PatrickBaus/LiPo_heater/images/main.png

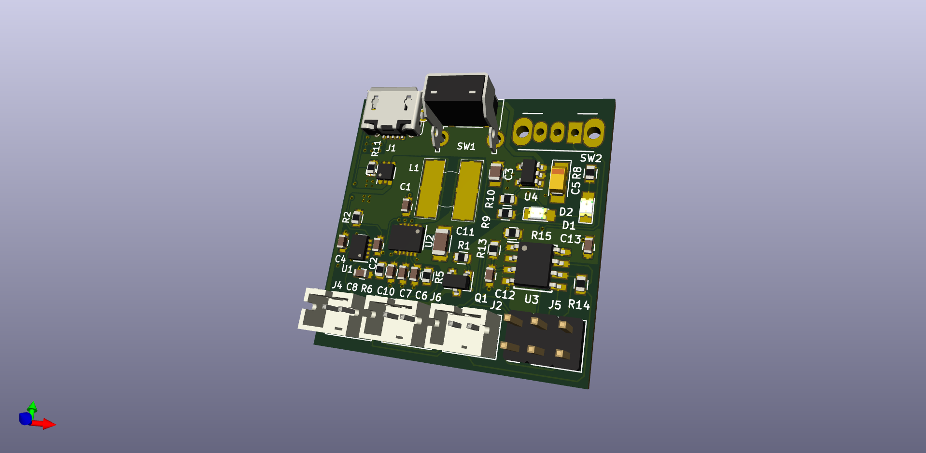
images/main.png
