PatrickBaus/LiPo_heater/components/Seuthe_nr-5.jpg

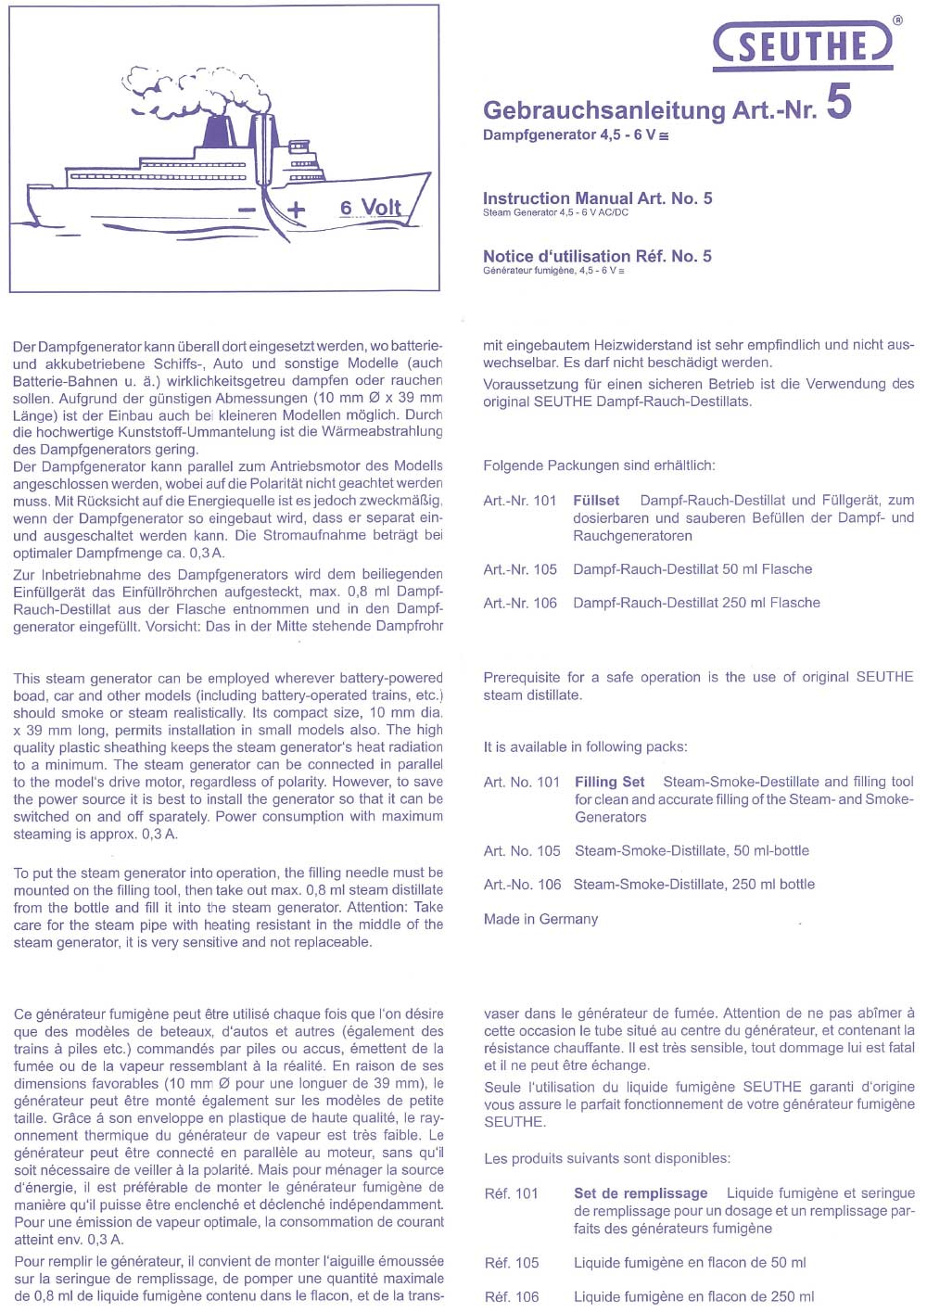
components/Seuthe_nr-5.jpg
