PatrickBaus/LiPo_heater/main.kicad_pcb

## KiCad design main.kicad_pcb (2018-06-10)

Schematic: main.sch

Parts:
J1: USB_MICRO
J2, J3: Conn_01x02; JST_PH_B2B-PH-K_02x2.00mm_Straight
LOGO1: Logo_Open_Hardware_Small; OSHW-Logo_7.5x8mm_SilkScreen
Q1: DMP1045U; SOT-23
R1: 10k; R_0603_1608Metric

Connections:
/BAT+: J2.1; also elsewhere on the board
/Microcontroller/~enable_heater: Q1.1, R1.2; also elsewhere on the board
/Power Supply/V+5: Q1.2, R1.1; also elsewhere on the board
/Power Supply/VUSB: J1.1; also elsewhere on the board
GND: J1.5, J1.6, J2.2, J3.2; also elsewhere on the board
unnamed: J3.1, Q1.3

Notes on the sheet:
Heater

Schematic: MCU.sch

Parts:
C10, C11, C12: 100n; C_0603_1608Metric
J6: Conn_01x02; JST_PH_B2B-PH-K_02x2.00mm_Straight
J7: AVR-ISP-6; PinHeader_2x03_P2.54mm_Vertical
Q3: MMBT3904; SOT-23
R13: 1k; R_0603_1608Metric
R14, R17, R18: 4.7k; R_0603_1608Metric
R15: 470; R_0603_1608Metric
R16: 10k; R_0603_1608Metric
SW2: SW_SPDT; SW_CuK_OS102011MA1QN1_SPDT_Angled
U4: ATtiny13-20SSU; SOIC-8_3.9x4.9mm_P1.27mm

Connections:
/BAT+: R13.2; also elsewhere on the board
/Microcontroller/MISO: J7.1, R18.2, U4.6 (PB1)
/Microcontroller/MOSI: J7.4, R17.2, U4.5 (PB0)
/Microcontroller/RST: J7.5, R16.2, U4.1 (~RESET~/PB5)
/Microcontroller/SCK: J7.3, R14.2, U4.7 (PB2)
/Microcontroller/~enable_heater: U4.2 (PB3); also elsewhere on the board
/Power Supply/V+5: C10.1, J7.2, R15.1, R16.1, U4.8 (VCC); also elsewhere on the board
/Power Supply/~Kill_power: R17.1; also elsewhere on the board
GND: C10.2, C11.2, C12.2, J7.6, Q3.2 (E), SW2.1, U4.4 (GND); also elsewhere on the board
unnamed: C11.1, R13.1, U4.3 (PB4)
unnamed: C12.1, R14.1, SW2.2
unnamed: J6.1, R15.2
unnamed: J6.2, Q3.3 (C)
unnamed: Q3.1 (B), R18.1

Notes on the sheet:
To program the arduino. Connect the following wires: GND -> Pin 6 CTS -> Not Connected 5V/3.3V -> Pin 2 TXD ->
We are using a transistor so that we can isolate the pin using a 4.7k resistor

Schematic: charger.sch, Battery Charger

Parts:
C1, C2: 10u; C_0805_2012Metric
D1: Red LED; LED_0805_2012Metric
D2: Green LED; LED_0805_2012Metric
R2: 470; R_0603_1608Metric
R3: 1k; R_0603_1608Metric
R4: 2k; R_0603_1608Metric
U1: MCP73831; SOT-23-5

Connections:
/BAT+: C2.1, U1.3; also elsewhere on the board
/Power Supply/VUSB: C1.1, R2.2, U1.4; also elsewhere on the board
GND: C1.2, C2.2, R3.1, R4.1, U1.2; also elsewhere on the board
unnamed: D1.1, D2.2, U1.1
unnamed: D1.2, R2.1
unnamed: D2.1, R3.2
unnamed: R4.2, U1.5

Notes on the sheet:
Turns on, when fully charged
Turns on, when the charger is connected

Schematic: load_sharing.sch, Load Sharing Circuit

Parts:
Q2: NTLJF3117P; DFN-6-2EP_2x2mm_Pitch0.65mm
R5: 100k; R_0603_1608Metric

Connections:
/BAT+: Q2.3, Q2.8; also elsewhere on the board
/Power Supply/DC/DC boost converter/Vsup: Q2.4, Q2.6, Q2.7; also elsewhere on the board
/Power Supply/VUSB: Q2.1, Q2.5, R5.1; also elsewhere on the board
GND: R5.2; also elsewhere on the board

Schematic: boost_converter.sch

Parts:
C3: 10n; C_0603_1608Metric
C4, C8, C9: 47u; C_0805_2012Metric
C5: 100n; C_0603_1608Metric
C6: 200p; C_0603_1608Metric
C7: 18p; C_0603_1608Metric
D3: LED; LED_0805_2012Metric
JP1, JP2: SolderJumper_2_Open; SolderJumper-2_P1.3mm_Open_RoundedPad1.0x1.5mm
L1: 22u; Coilcraft_MSS7341
R6, R19: 1k; R_0603_1608Metric
R7: 100k; R_0603_1608Metric
R8: 332k; R_0603_1608Metric
R9: 33k; R_0603_1608Metric
R10: 150k; R_0603_1608Metric
R11: 22.6k; R_0603_1608Metric
R12: 1.1M; R_0603_1608Metric
SW1: SW_Push; SW_Tactile_SPST_Angled_PTS645Vx31-2LFS
TP1: Test_Point; TestPoint_Pad_D1.5mm
U2: LTC2955-1(DFN); DFN-10-1EP_2x3mm_P0.5mm_EP0.64x2.4mm
U3: LTC3536; DFN-10-1EP_3x3mm_P0.5mm_EP1.55x2.48mm

Connections:
/Power Supply/DC/DC boost converter/Vsup: C4.1, JP1.1, R6.1, U3.7; also elsewhere on the board
/Power Supply/V+5: C8.1, C9.1, JP2.1, R11.1, R12.1, R19.1, TP1.1, U3.6; also elsewhere on the board
/Power Supply/~Kill_power: JP2.2, U2.9; also elsewhere on the board
GND: C3.2, C4.2, C5.2, C8.2, C9.2, D3.1, R7.2, R8.2, R10.2, SW1.1, U2.6, U2.7, U2.10, U3.2, U3.3, U3.11; also elsewhere on the board
unnamed: C3.1, R6.2, U2.4
unnamed: C5.1, U2.8
unnamed: C6.1, R9.1
unnamed: C6.2, C7.2, R10.1, R12.2, U3.9
unnamed: C7.1, R11.2
unnamed: D3.2, R19.2
unnamed: JP1.2, R7.1, U2.3, U3.8
unnamed: L1.1, U3.4
unnamed: L1.2, U3.5
unnamed: R8.1, U3.1
unnamed: R9.2, U3.10
unnamed: SW1.2, U2.5

Notes on the sheet:
5.2 seconds/μF + 64 ms until forced shutdown
332 kΩ ≜ 300 kHz
Optional: Close JP1 for debugging to always enable the DC/DC converter
Optional: Close JP2 for debugging to keep the DC/DC converter enabled
The LTC2955 requires only 1.2 µA of current so the 1k resistor is OK and it allows reverse input.

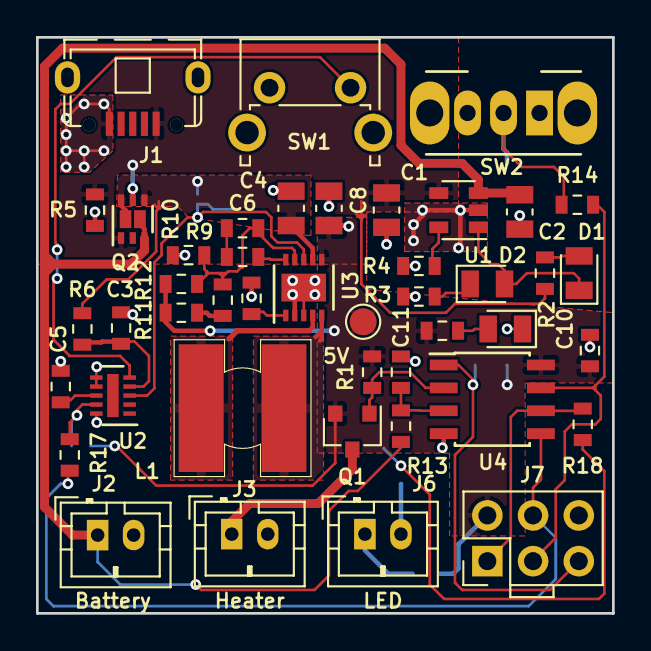
[picture p3: board main.kicad_pcb from above]

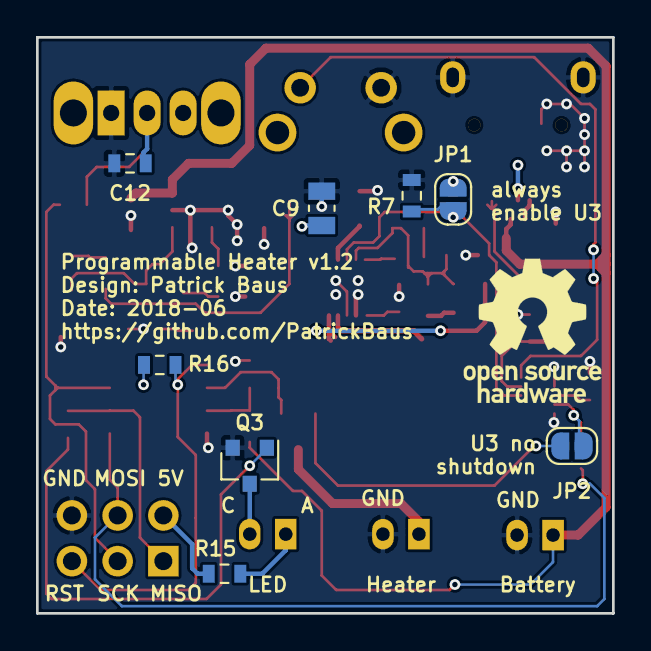
[picture p4: board main.kicad_pcb from below]

Board: 2 copper layers, 32.0 x 32.0 mm, 53 parts (9 on the bottom side), 33 nets.
