PatrickBaus/LiPo_heater/(commit log)

2017-10-31 Fixed NTLJF3117P MOSFET pin layout
    [BOM.csv, MCU.sch, boost_converter.sch, charger.sch, load_sharing.sch, main.csv, main.kicad_pcb, main.sch]
2017-12-30 Moved MCU pins around to make sure that they do not interfere with the programmer Moved ISP Header closer to the edge of the board to allow easier access with the programmer Added pulldown resistor t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
    [MCU.sch, boost_converter.sch, charger.sch, load_sharing.sch, main.kicad_pcb, main.sch, power_supply.sch]
2017-12-30 Added part names and BOM Added Gerber files
    [BOM.csv, MCU.sch, boost_converter.sch, charger.sch, load_sharing.sch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]
2018-03-19 Preparing for v1.2 Updated to KiCAD 5 nightly Added resistors to isolate the programming pins Added transistor to drive the LED Replaced LTC3458 boost converter with an LTC3536 buck-boost converter t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
    [MCU.sch, boost_converter.sch, charger.sch, load_sharing.sch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]
2018-05-24 Updated to Kicad v5.0
    [MCU.sch, boost_converter.sch, charger.sch, load_sharing.sch, main.kicad_pcb, main.sch]
2018-05-24 Added Gerber files v1.2
    [main-B.Cu.gbr, main-B.Mask.gbr, main-B.SilkS.gbr, main-Edge.Cuts.gbr, main-F.Cu.gbr, main-F.Mask.gbr, main-F.SilkS.gbr, main-NPTH.drl]
2018-06-10 Added power on state LED Updated to KiCAD 5.0
    [MCU.sch, boost_converter.sch, charger.sch, load_sharing.sch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]
2018-06-10 Added part numbers Updated BOM
    [BOM.csv, MCU.sch, boost_converter.sch, charger.sch]
2018-06-16 Changed description of the blue LED
    [boost_converter.sch]
